Hoektronics/Mouth.IO/electronics/brainboard/brainboard.pdf

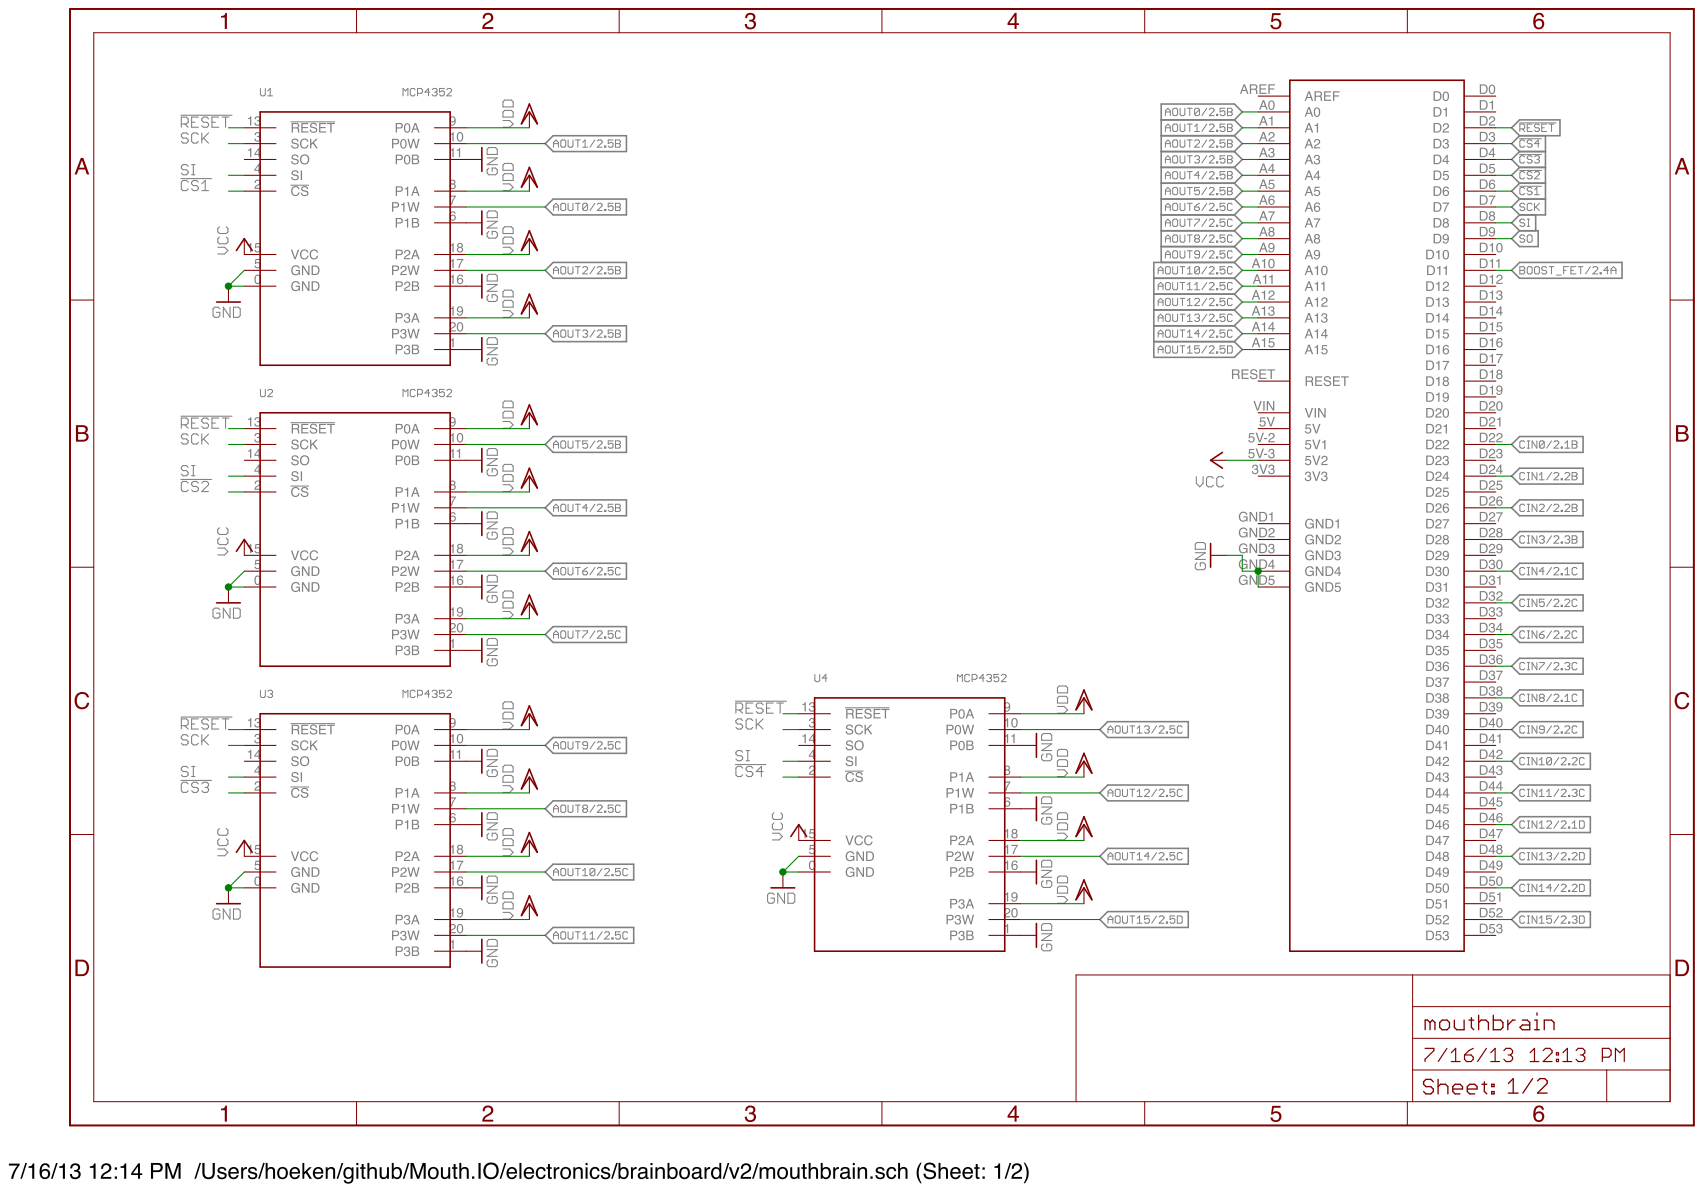
[picture p4: page 1]
