Hoektronics/Mouth.IO/electronics/tongueboard/tongueboard.pdf

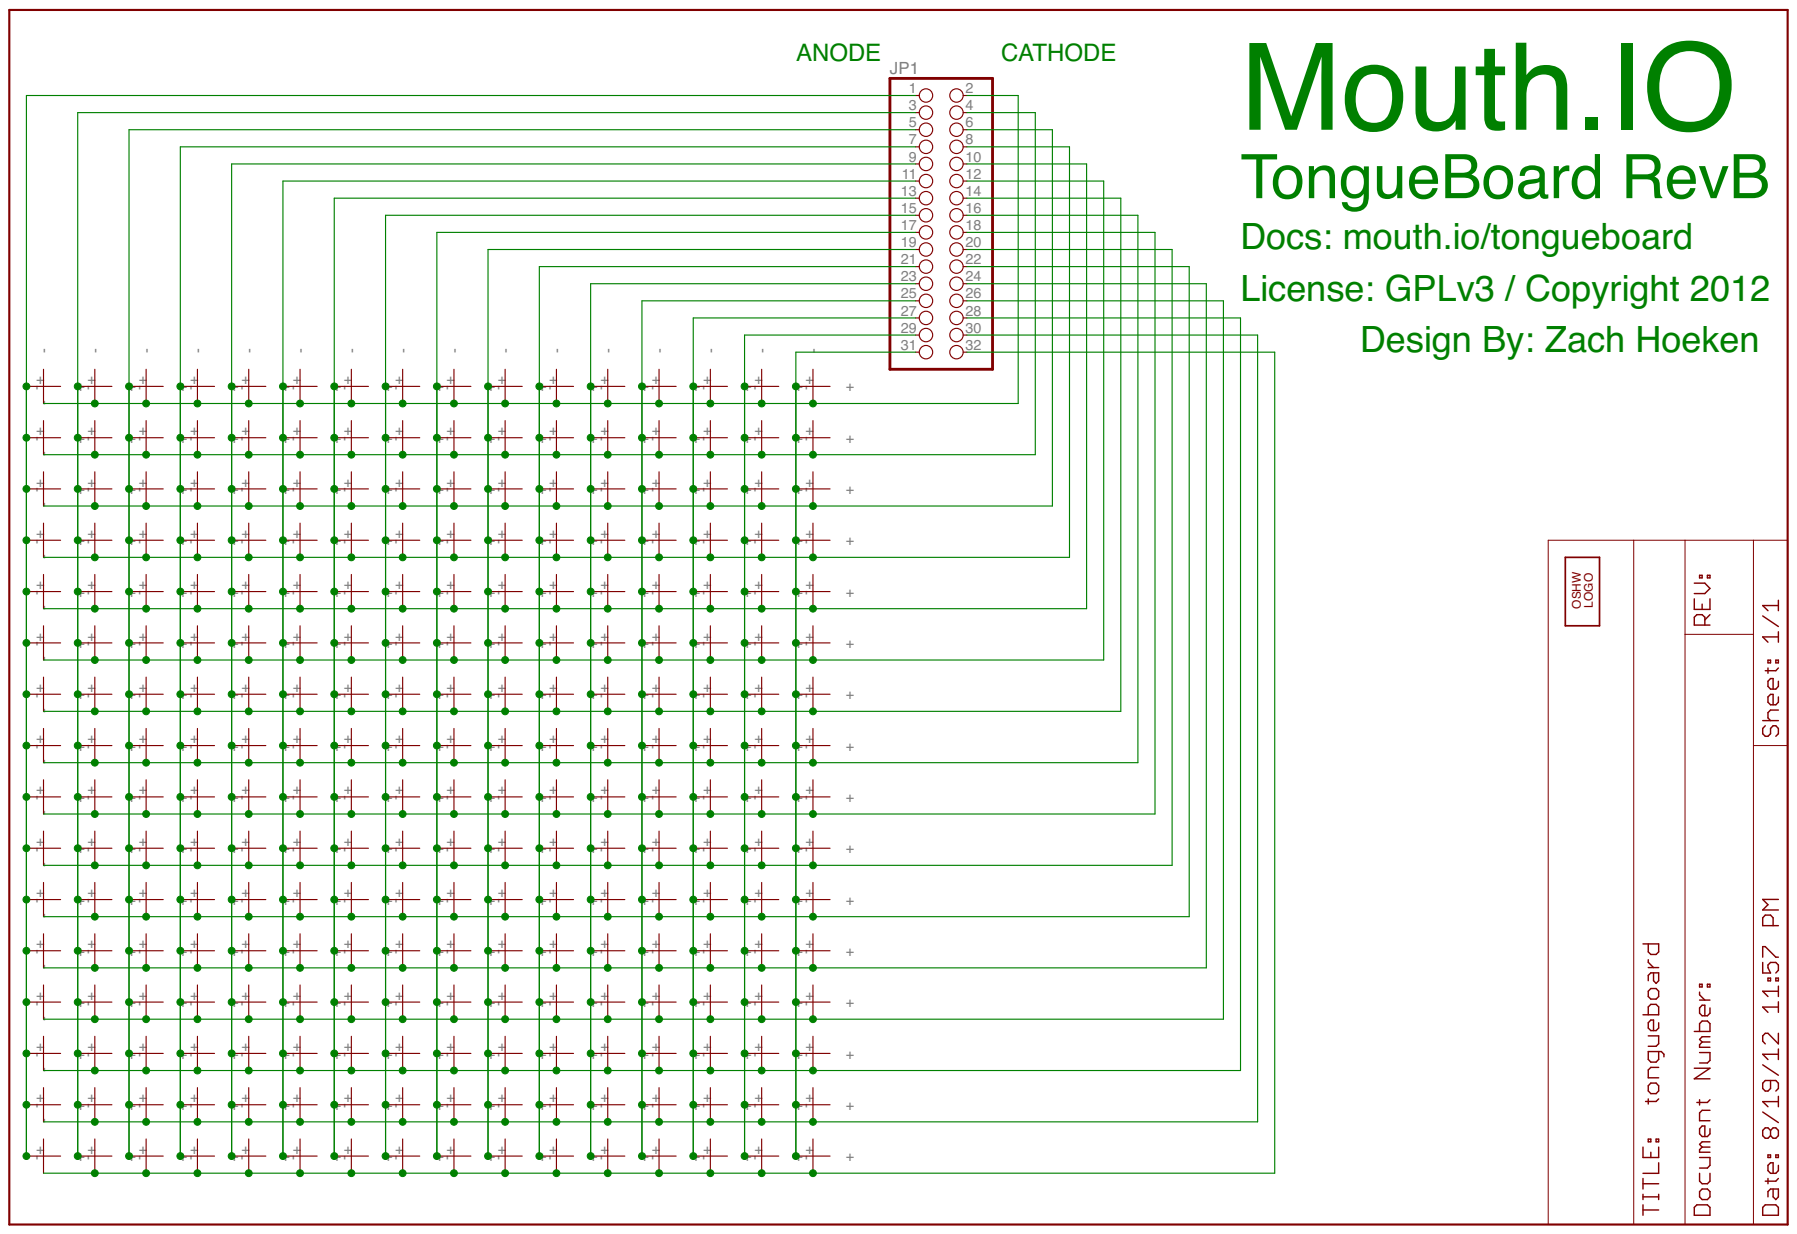
[picture p5: page 1]

Docs: mouth.io/tongueboard
License: GPLv3 / Copyright 2012

Design By: Zach Hoeken
