Hoektronics/Mouth.IO/electronics/brainboard/brainboard.brd

## EAGLE design electronics/brainboard/brainboard.brd (2013-07-16)

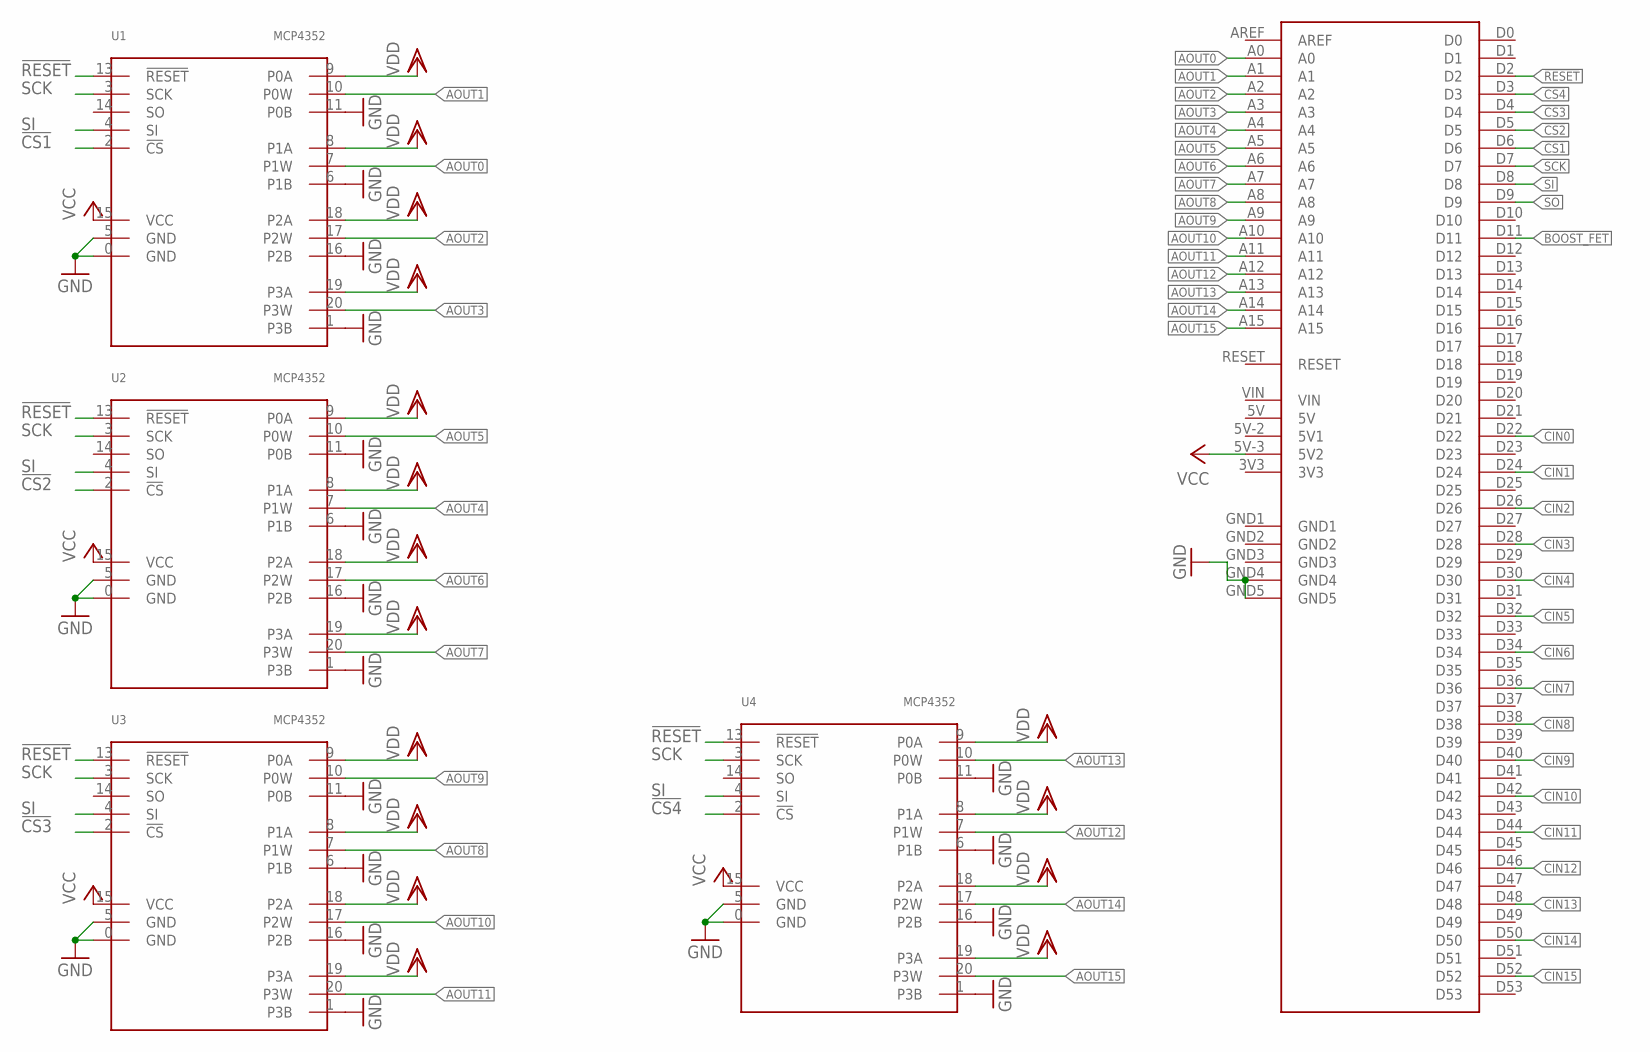
[picture p6: schematic brainboard.sch, sheet 1]

Parts:
U1, U2, U3, U4: MCP4352; QFN-20-PAD
U$3: ARDUINO-MEGA

Connections:
!CS1: U1.2 (!CS), U$3.D6
!CS2: U2.2 (!CS), U$3.D5
!CS3: U3.2 (!CS), U$3.D4
!CS4: U4.2 (!CS), U$3.D3
!RESET: U1.13 (!RESET), U2.13 (!RESET), U3.13 (!RESET), U4.13 (!RESET), U$3.D2
AOUT0: U1.7 (P1W), U$3.A0; also elsewhere on the board
AOUT1: U1.10 (P0W), U$3.A1; also elsewhere on the board
AOUT2: U1.17 (P2W), U$3.A2; also elsewhere on the board
AOUT3: U1.20 (P3W), U$3.A3; also elsewhere on the board
AOUT4: U2.7 (P1W), U$3.A4; also elsewhere on the board
AOUT5: U2.10 (P0W), U$3.A5; also elsewhere on the board
AOUT6: U2.17 (P2W), U$3.A6; also elsewhere on the board
AOUT7: U2.20 (P3W), U$3.A7; also elsewhere on the board
AOUT8: U3.7 (P1W), U$3.A8; also elsewhere on the board
AOUT9: U3.10 (P0W), U$3.A9; also elsewhere on the board
AOUT10: U3.17 (P2W), U$3.A10; also elsewhere on the board
AOUT11: U3.20 (P3W), U$3.A11; also elsewhere on the board
AOUT12: U4.7 (P1W), U$3.A12; also elsewhere on the board
AOUT13: U4.10 (P0W), U$3.A13; also elsewhere on the board
AOUT14: U4.17 (P2W), U$3.A14; also elsewhere on the board
AOUT15: U4.20 (P3W), U$3.A15; also elsewhere on the board
BOOST_FET: U$3.D11; also elsewhere on the board
CIN0: U$3.D22; also elsewhere on the board
CIN1: U$3.D24; also elsewhere on the board
CIN2: U$3.D26; also elsewhere on the board
CIN3: U$3.D28; also elsewhere on the board
CIN4: U$3.D30; also elsewhere on the board
CIN5: U$3.D32; also elsewhere on the board
CIN6: U$3.D34; also elsewhere on the board
CIN7: U$3.D36; also elsewhere on the board
CIN8: U$3.D38; also elsewhere on the board
CIN9: U$3.D40; also elsewhere on the board
CIN10: U$3.D42; also elsewhere on the board
CIN11: U$3.D44; also elsewhere on the board
CIN12: U$3.D46; also elsewhere on the board
CIN13: U$3.D48; also elsewhere on the board
CIN14: U$3.D50; also elsewhere on the board
CIN15: U$3.D52; also elsewhere on the board
GND: U1.0 (GND), U1.1 (P3B), U1.5 (GND), U1.6 (P1B), U1.11 (P0B), U1.16 (P2B), U2.0 (GND), U2.1 (P3B), U2.5 (GND), U2.6 (P1B), U2.11 (P0B), U2.16 (P2B), U3.0 (GND), U3.1 (P3B), U3.5 (GND), U3.6 (P1B), U3.11 (P0B), U3.16 (P2B), U4.0 (GND), U4.1 (P3B), U4.5 (GND), U4.6 (P1B), U4.11 (P0B), U4.16 (P2B), U$3.GND4, U$3.GND5; also elsewhere on the board
SCK: U1.3 (SCK), U2.3 (SCK), U3.3 (SCK), U4.3 (SCK), U$3.D7
SI: U1.4 (SI), U2.4 (SI), U3.4 (SI), U4.4 (SI), U$3.D8
SO: U$3.D9
VCC: U1.15 (VCC), U2.15 (VCC), U3.15 (VCC), U4.15 (VCC), U$3.5V-3 (5V2); also elsewhere on the board
VDD: U1.8 (P1A), U1.9 (P0A), U1.18 (P2A), U1.19 (P3A), U2.8 (P1A), U2.9 (P0A), U2.18 (P2A), U2.19 (P3A), U3.8 (P1A), U3.9 (P0A), U3.18 (P2A), U3.19 (P3A), U4.8 (P1A), U4.9 (P0A), U4.18 (P2A), U4.19 (P3A); also elsewhere on the board

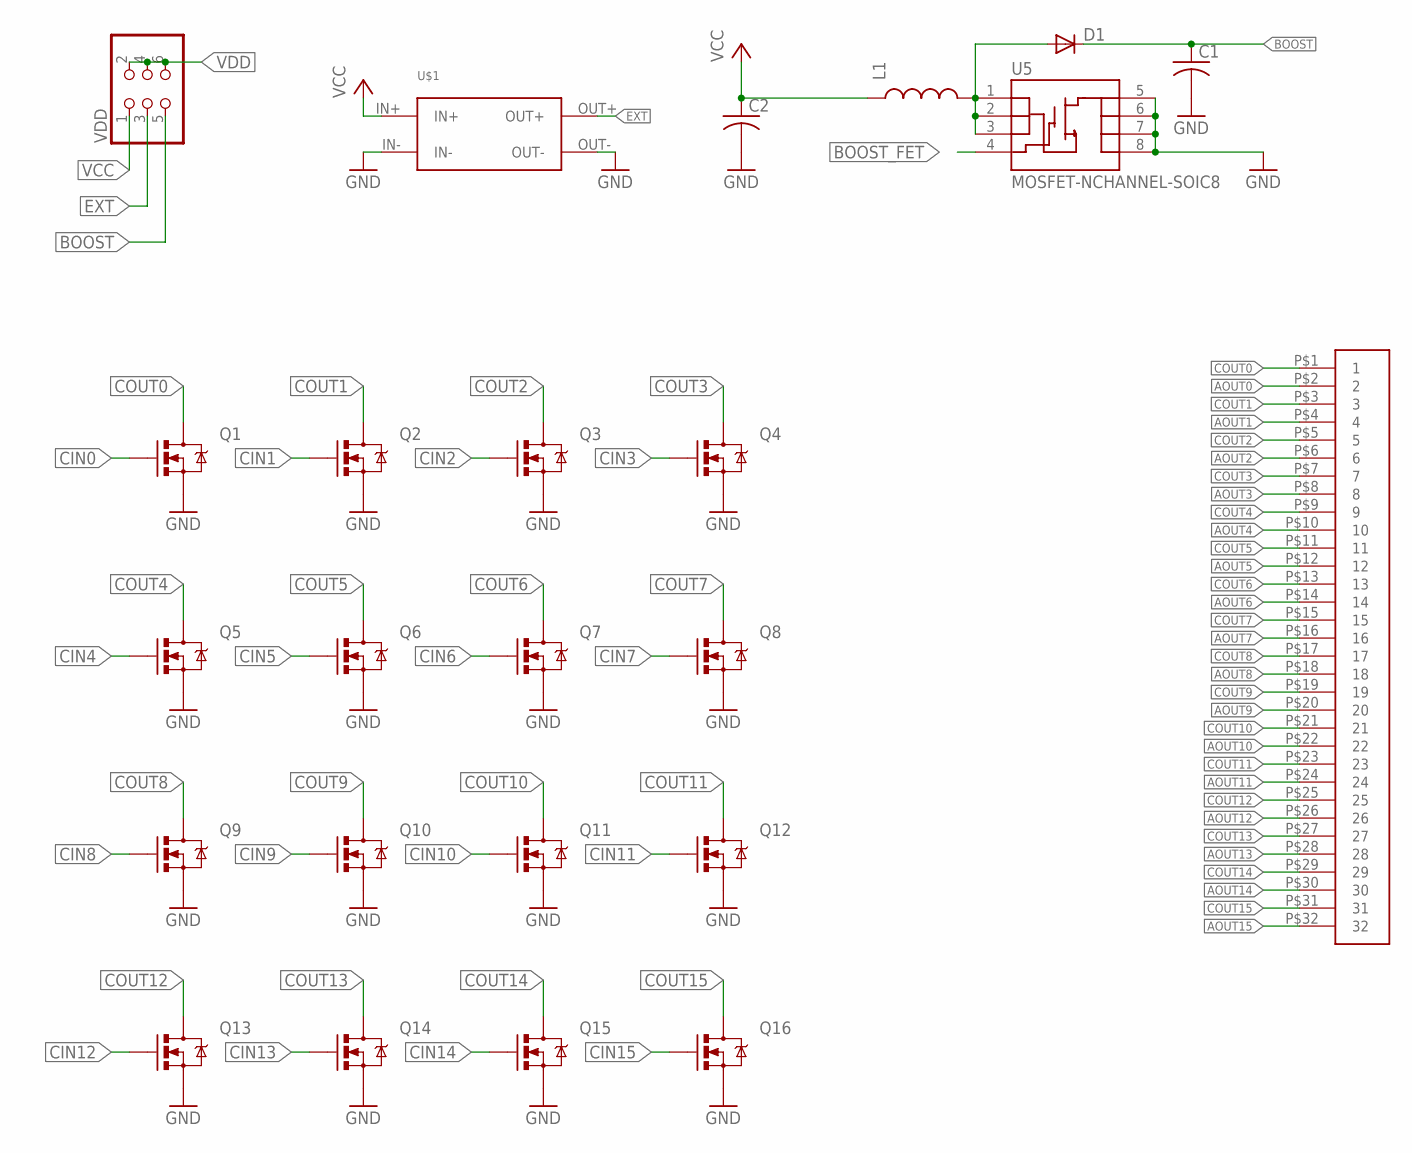
[picture p7: schematic brainboard.sch, sheet 2]

Parts:
C1, C2: C-USC1206; C1206
D1: DIODESMA; SMA-DIODE
L1: INDUCTOR1206H*; INDUCTOR-1206
Q1, Q2, Q3, Q4, Q5, Q6, Q7, Q8, Q9, Q10, Q11, Q12, Q13, Q14, Q15, Q16: MOSFET-NCHANNELSMD; SOT23-3
U5: MOSFET-NCHANNEL-SOIC8; SO08
U$1: DC-DC-CONVERTER; DC-DC-MODULE
U$2: FPC-0.5-32HORIZ; FPC-32-HORIZONTAL
VDD: PINHD-2X3; 2X03

Connections:
AOUT0: U$2.P$2 (2); also elsewhere on the board
AOUT1: U$2.P$4 (4); also elsewhere on the board
AOUT2: U$2.P$6 (6); also elsewhere on the board
AOUT3: U$2.P$8 (8); also elsewhere on the board
AOUT4: U$2.P$10 (10); also elsewhere on the board
AOUT5: U$2.P$12 (12); also elsewhere on the board
AOUT6: U$2.P$14 (14); also elsewhere on the board
AOUT7: U$2.P$16 (16); also elsewhere on the board
AOUT8: U$2.P$18 (18); also elsewhere on the board
AOUT9: U$2.P$20 (20); also elsewhere on the board
AOUT10: U$2.P$22 (22); also elsewhere on the board
AOUT11: U$2.P$24 (24); also elsewhere on the board
AOUT12: U$2.P$26 (26); also elsewhere on the board
AOUT13: U$2.P$28 (28); also elsewhere on the board
AOUT14: U$2.P$30 (30); also elsewhere on the board
AOUT15: U$2.P$32 (32); also elsewhere on the board
BOOST: C1.1, D1.C, VDD.5
BOOST_FET: U5.4 (G); also elsewhere on the board
CIN0: Q1.1 (G); also elsewhere on the board
CIN1: Q2.1 (G); also elsewhere on the board
CIN2: Q3.1 (G); also elsewhere on the board
CIN3: Q4.1 (G); also elsewhere on the board
CIN4: Q5.1 (G); also elsewhere on the board
CIN5: Q6.1 (G); also elsewhere on the board
CIN6: Q7.1 (G); also elsewhere on the board
CIN7: Q8.1 (G); also elsewhere on the board
CIN8: Q9.1 (G); also elsewhere on the board
CIN9: Q10.1 (G); also elsewhere on the board
CIN10: Q11.1 (G); also elsewhere on the board
CIN11: Q12.1 (G); also elsewhere on the board
CIN12: Q13.1 (G); also elsewhere on the board
CIN13: Q14.1 (G); also elsewhere on the board
CIN14: Q15.1 (G); also elsewhere on the board
CIN15: Q16.1 (G); also elsewhere on the board
COUT0: Q1.3 (D), U$2.P$1 (1)
COUT1: Q2.3 (D), U$2.P$3 (3)
COUT2: Q3.3 (D), U$2.P$5 (5)
COUT3: Q4.3 (D), U$2.P$7 (7)
COUT4: Q5.3 (D), U$2.P$9 (9)
COUT5: Q6.3 (D), U$2.P$11 (11)
COUT6: Q7.3 (D), U$2.P$13 (13)
COUT7: Q8.3 (D), U$2.P$15 (15)
COUT8: Q9.3 (D), U$2.P$17 (17)
COUT9: Q10.3 (D), U$2.P$19 (19)
COUT10: Q11.3 (D), U$2.P$21 (21)
COUT11: Q12.3 (D), U$2.P$23 (23)
COUT12: Q13.3 (D), U$2.P$25 (25)
COUT13: Q14.3 (D), U$2.P$27 (27)
COUT14: Q15.3 (D), U$2.P$29 (29)
COUT15: Q16.3 (D), U$2.P$31 (31)
EXT: U$1.OUT+, VDD.3
GND: C1.2, C2.2, Q1.2 (S), Q2.2 (S), Q3.2 (S), Q4.2 (S), Q5.2 (S), Q6.2 (S), Q7.2 (S), Q8.2 (S), Q9.2 (S), Q10.2 (S), Q11.2 (S), Q12.2 (S), Q13.2 (S), Q14.2 (S), Q15.2 (S), Q16.2 (S), U5.5 (D), U5.6 (D), U5.7 (D), U5.8 (D), U$1.IN-, U$1.OUT-; also elsewhere on the board
unnamed: D1.A, L1.P$2 (2), U5.1 (S), U5.2 (S), U5.3 (S)
VCC: C2.1, L1.P$1 (1), U$1.IN+, VDD.1; also elsewhere on the board
VDD: VDD.2, VDD.4, VDD.6; also elsewhere on the board

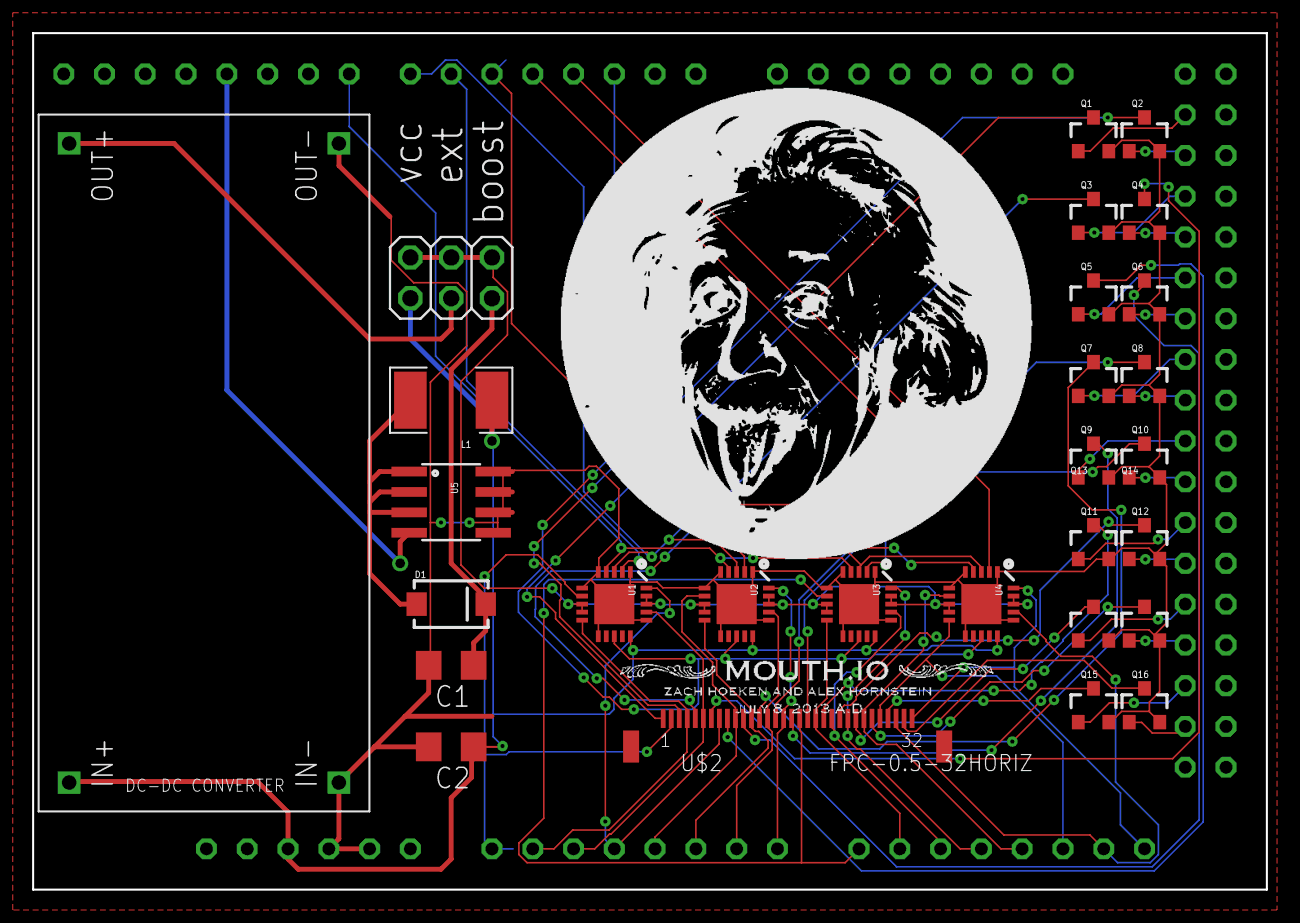
[picture p8: board brainboard.brd from above]

Board: 2 copper layers, 76.8 x 53.3 mm, 29 parts (0 on the bottom side), 62 nets.
