Hoektronics/Mouth.IO/electronics/tongueboard/tongueboard.brd

## EAGLE design electronics/tongueboard/tongueboard.brd (2013-07-11)

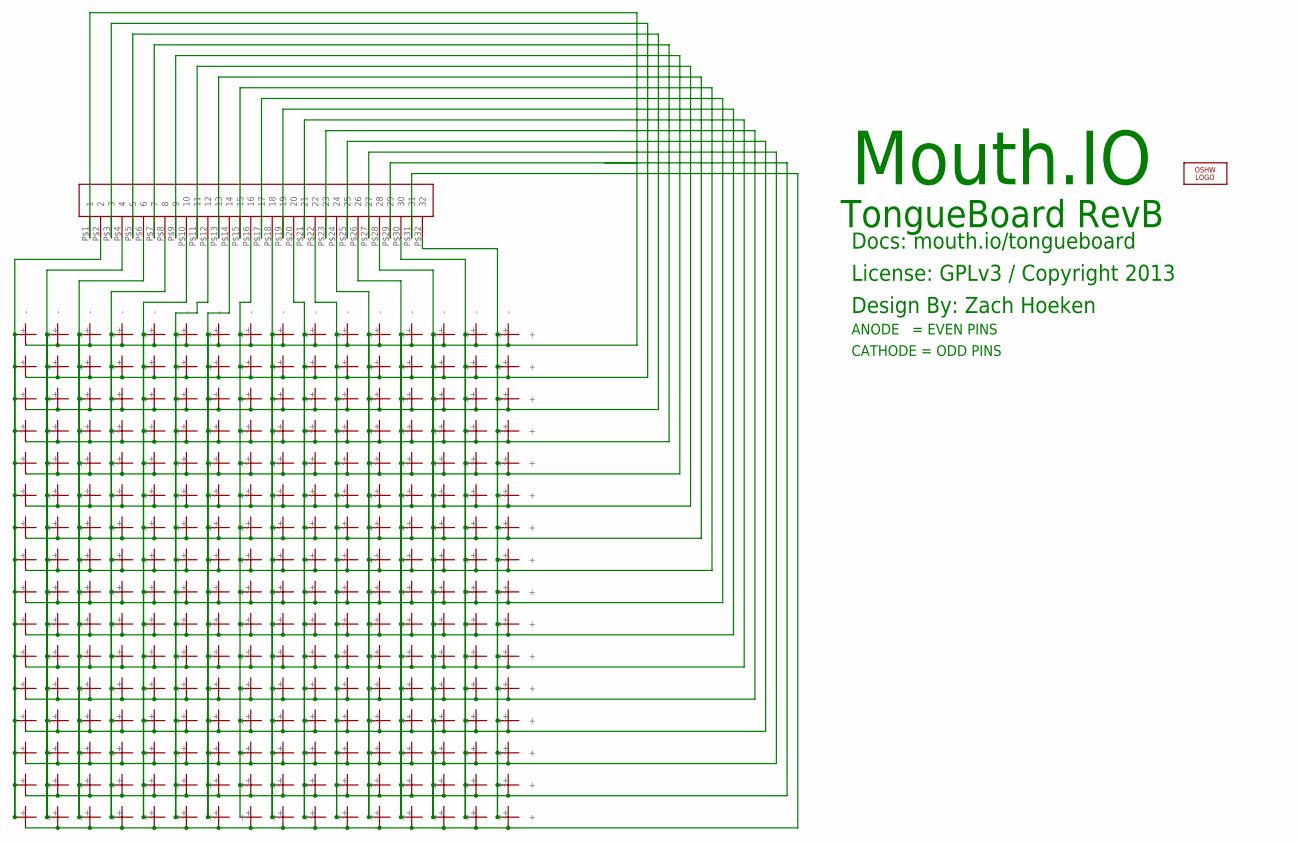
[picture p9: schematic tongueboard.sch]

Parts:
LOGO1: OSHW_LOGO_10MIL; OSHW_10X500_NOTEXT_COPPER
U$1, U$2, U$3, U$4, U$5, U$6, U$7, U$8, U$9, U$10, U$11, U$12, U$13, U$14, U$15, U$17, U$18, U$19, U$20, U$21, U$22, U$23, U$24, U$25, U$26, U$27, U$28, U$29, U$30, U$32, U$33, U$34, U$35, U$36, U$37, U$38, U$39, U$40, U$41, U$42, U$43, U$44, U$45, U$47, U$48, U$49, U$50, U$51, U$52, U$53, U$54, U$55, U$56, U$57, U$58, U$59, U$60, U$62, U$63, U$64, U$65, U$66, U$67, U$68, U$69, U$70, U$71, U$72, U$73, U$74, U$75, U$77, U$78, U$79, U$80, U$81, U$82, U$83, U$84, U$85, U$86, U$87, U$88, U$89, U$90, U$92, U$93, U$94, U$95, U$96, U$97, U$98, U$99, U$100, U$101, U$102, U$103, U$104, U$105, U$107, U$108, U$109, U$110, U$111, U$112, U$113, U$114, U$115, U$116, U$117, U$118, U$119, U$120, U$122, U$123, U$124, U$125, U$126, U$127, U$128, U$129, U$130, U$131, U$132, U$133, U$134, U$135, U$137, U$138, U$139, U$140, U$141, U$142, U$143, U$144, U$145, U$146, U$147, U$148, U$149, U$150, U$152, U$153, U$154, U$155, U$156, U$157, U$158, U$159, U$160, U$161, U$162, U$163, U$164, U$165, U$167, U$168, U$169, U$170, U$171, U$172, U$173, U$174, U$175, U$176, U$177, U$178, U$179, U$180, U$182, U$183, U$184, U$185, U$186, U$187, U$188, U$189, U$190, U$191, U$192, U$193, U$194, U$195, U$197, U$198, U$199, U$200, U$201, U$202, U$203, U$204, U$205, U$206, U$207, U$208, U$209, U$210, U$212, U$213, U$214, U$215, U$216, U$217, U$218, U$219, U$220, U$221, U$222, U$223, U$224, U$225, U$227, U$228, U$229, U$230, U$231, U$232, U$233, U$234, U$235, U$236, U$237, U$238, U$239, U$240, U$242, U$243, U$244, U$245, U$246, U$247, U$248, U$249, U$250, U$251, U$252, U$253, U$254, U$255, U$256: ELECTRODE60MIL; 61MIL
U$16, U$31, U$46, U$61, U$76, U$91, U$106, U$121, U$136, U$151, U$166, U$181, U$196, U$211, U$226, U$241: ELECTRODE61MILJCT; 61MILJCT
U$257: FPC-0.5-32; FPC-32-WIRE

Connections:
A0: U$1.+, U$17.+, U$33.+, U$49.+, U$65.+, U$81.+, U$97.+, U$113.+, U$129.+, U$145.+, U$161.+, U$177.+, U$193.+, U$209.+, U$225.+, U$241.+, U$257.P$2 (2)
A1: U$2.+, U$18.+, U$34.+, U$50.+, U$66.+, U$82.+, U$98.+, U$114.+, U$130.+, U$146.+, U$162.+, U$178.+, U$194.+, U$210.+, U$226.+, U$242.+, U$257.P$4 (4)
A2: U$3.+, U$19.+, U$35.+, U$51.+, U$67.+, U$83.+, U$99.+, U$115.+, U$131.+, U$147.+, U$163.+, U$179.+, U$195.+, U$211.+, U$227.+, U$243.+, U$257.P$6 (6)
A3: U$4.+, U$20.+, U$36.+, U$52.+, U$68.+, U$84.+, U$100.+, U$116.+, U$132.+, U$148.+, U$164.+, U$180.+, U$196.+, U$212.+, U$228.+, U$244.+, U$257.P$8 (8)
A4: U$5.+, U$21.+, U$37.+, U$53.+, U$69.+, U$85.+, U$101.+, U$117.+, U$133.+, U$149.+, U$165.+, U$181.+, U$197.+, U$213.+, U$229.+, U$245.+, U$257.P$10 (10)
A5: U$6.+, U$22.+, U$38.+, U$54.+, U$70.+, U$86.+, U$102.+, U$118.+, U$134.+, U$150.+, U$166.+, U$182.+, U$198.+, U$214.+, U$230.+, U$246.+, U$257.P$12 (12)
A6: U$7.+, U$23.+, U$39.+, U$55.+, U$71.+, U$87.+, U$103.+, U$119.+, U$135.+, U$151.+, U$167.+, U$183.+, U$199.+, U$215.+, U$231.+, U$247.+, U$257.P$14 (14)
A7: U$8.+, U$24.+, U$40.+, U$56.+, U$72.+, U$88.+, U$104.+, U$120.+, U$136.+, U$152.+, U$168.+, U$184.+, U$200.+, U$216.+, U$232.+, U$248.+, U$257.P$16 (16)
A8: U$9.+, U$25.+, U$41.+, U$57.+, U$73.+, U$89.+, U$105.+, U$121.+, U$137.+, U$153.+, U$169.+, U$185.+, U$201.+, U$217.+, U$233.+, U$249.+, U$257.P$18 (18)
A9: U$10.+, U$26.+, U$42.+, U$58.+, U$74.+, U$90.+, U$106.+, U$122.+, U$138.+, U$154.+, U$170.+, U$186.+, U$202.+, U$218.+, U$234.+, U$250.+, U$257.P$20 (20)
A10: U$11.+, U$27.+, U$43.+, U$59.+, U$75.+, U$91.+, U$107.+, U$123.+, U$139.+, U$155.+, U$171.+, U$187.+, U$203.+, U$219.+, U$235.+, U$251.+, U$257.P$22 (22)
A11: U$12.+, U$28.+, U$44.+, U$60.+, U$76.+, U$92.+, U$108.+, U$124.+, U$140.+, U$156.+, U$172.+, U$188.+, U$204.+, U$220.+, U$236.+, U$252.+, U$257.P$24 (24)
A12: U$13.+, U$29.+, U$45.+, U$61.+, U$77.+, U$93.+, U$109.+, U$125.+, U$141.+, U$157.+, U$173.+, U$189.+, U$205.+, U$221.+, U$237.+, U$253.+, U$257.P$26 (26)
A13: U$14.+, U$30.+, U$46.+, U$62.+, U$78.+, U$94.+, U$110.+, U$126.+, U$142.+, U$158.+, U$174.+, U$190.+, U$206.+, U$222.+, U$238.+, U$254.+, U$257.P$28 (28)
A14: U$15.+, U$31.+, U$47.+, U$63.+, U$79.+, U$95.+, U$111.+, U$127.+, U$143.+, U$159.+, U$175.+, U$191.+, U$207.+, U$223.+, U$239.+, U$255.+, U$257.P$30 (30)
A15: U$16.+, U$32.+, U$48.+, U$64.+, U$80.+, U$96.+, U$112.+, U$128.+, U$144.+, U$160.+, U$176.+, U$192.+, U$208.+, U$224.+, U$240.+, U$256.+, U$257.P$32 (32)
C0: U$241.-, U$242.-, U$243.-, U$244.-, U$245.-, U$246.-, U$247.-, U$248.-, U$249.-, U$250.-, U$251.-, U$252.-, U$253.-, U$254.-, U$255.-, U$256.-, U$257.P$1 (1)
C1: U$225.-, U$226.-, U$227.-, U$228.-, U$229.-, U$230.-, U$231.-, U$232.-, U$233.-, U$234.-, U$235.-, U$236.-, U$237.-, U$238.-, U$239.-, U$240.-, U$257.P$3 (3)
C2: U$209.-, U$210.-, U$211.-, U$212.-, U$213.-, U$214.-, U$215.-, U$216.-, U$217.-, U$218.-, U$219.-, U$220.-, U$221.-, U$222.-, U$223.-, U$224.-, U$257.P$5 (5)
C3: U$193.-, U$194.-, U$195.-, U$196.-, U$197.-, U$198.-, U$199.-, U$200.-, U$201.-, U$202.-, U$203.-, U$204.-, U$205.-, U$206.-, U$207.-, U$208.-, U$257.P$7 (7)
C4: U$177.-, U$178.-, U$179.-, U$180.-, U$181.-, U$182.-, U$183.-, U$184.-, U$185.-, U$186.-, U$187.-, U$188.-, U$189.-, U$190.-, U$191.-, U$192.-, U$257.P$9 (9)
C5: U$161.-, U$162.-, U$163.-, U$164.-, U$165.-, U$166.-, U$167.-, U$168.-, U$169.-, U$170.-, U$171.-, U$172.-, U$173.-, U$174.-, U$175.-, U$176.-, U$257.P$11 (11)
C6: U$145.-, U$146.-, U$147.-, U$148.-, U$149.-, U$150.-, U$151.-, U$152.-, U$153.-, U$154.-, U$155.-, U$156.-, U$157.-, U$158.-, U$159.-, U$160.-, U$257.P$13 (13)
C7: U$129.-, U$130.-, U$131.-, U$132.-, U$133.-, U$134.-, U$135.-, U$136.-, U$137.-, U$138.-, U$139.-, U$140.-, U$141.-, U$142.-, U$143.-, U$144.-, U$257.P$15 (15)
C8: U$113.-, U$114.-, U$115.-, U$116.-, U$117.-, U$118.-, U$119.-, U$120.-, U$121.-, U$122.-, U$123.-, U$124.-, U$125.-, U$126.-, U$127.-, U$128.-, U$257.P$17 (17)
C9: U$97.-, U$98.-, U$99.-, U$100.-, U$101.-, U$102.-, U$103.-, U$104.-, U$105.-, U$106.-, U$107.-, U$108.-, U$109.-, U$110.-, U$111.-, U$112.-, U$257.P$19 (19)
C10: U$81.-, U$82.-, U$83.-, U$84.-, U$85.-, U$86.-, U$87.-, U$88.-, U$89.-, U$90.-, U$91.-, U$92.-, U$93.-, U$94.-, U$95.-, U$96.-, U$257.P$21 (21)
C11: U$65.-, U$66.-, U$67.-, U$68.-, U$69.-, U$70.-, U$71.-, U$72.-, U$73.-, U$74.-, U$75.-, U$76.-, U$77.-, U$78.-, U$79.-, U$80.-, U$257.P$23 (23)
C12: U$49.-, U$50.-, U$51.-, U$52.-, U$53.-, U$54.-, U$55.-, U$56.-, U$57.-, U$58.-, U$59.-, U$60.-, U$61.-, U$62.-, U$63.-, U$64.-, U$257.P$25 (25)
C13: U$33.-, U$34.-, U$35.-, U$36.-, U$37.-, U$38.-, U$39.-, U$40.-, U$41.-, U$42.-, U$43.-, U$44.-, U$45.-, U$46.-, U$47.-, U$48.-, U$257.P$27 (27)
C14: U$17.-, U$18.-, U$19.-, U$20.-, U$21.-, U$22.-, U$23.-, U$24.-, U$25.-, U$26.-, U$27.-, U$28.-, U$29.-, U$30.-, U$31.-, U$32.-, U$257.P$29 (29)
C15: U$1.-, U$2.-, U$3.-, U$4.-, U$5.-, U$6.-, U$7.-, U$8.-, U$9.-, U$10.-, U$11.-, U$12.-, U$13.-, U$14.-, U$15.-, U$16.-, U$257.P$31 (31)

Notes on the sheet:
Mouth.IO
TongueBoard RevB
ANODE = EVEN PINS
CATHODE = ODD PINS
Docs: mouth.io/tongueboard
License: GPLv3 / Copyright 2013
Design By: Zach Hoeken

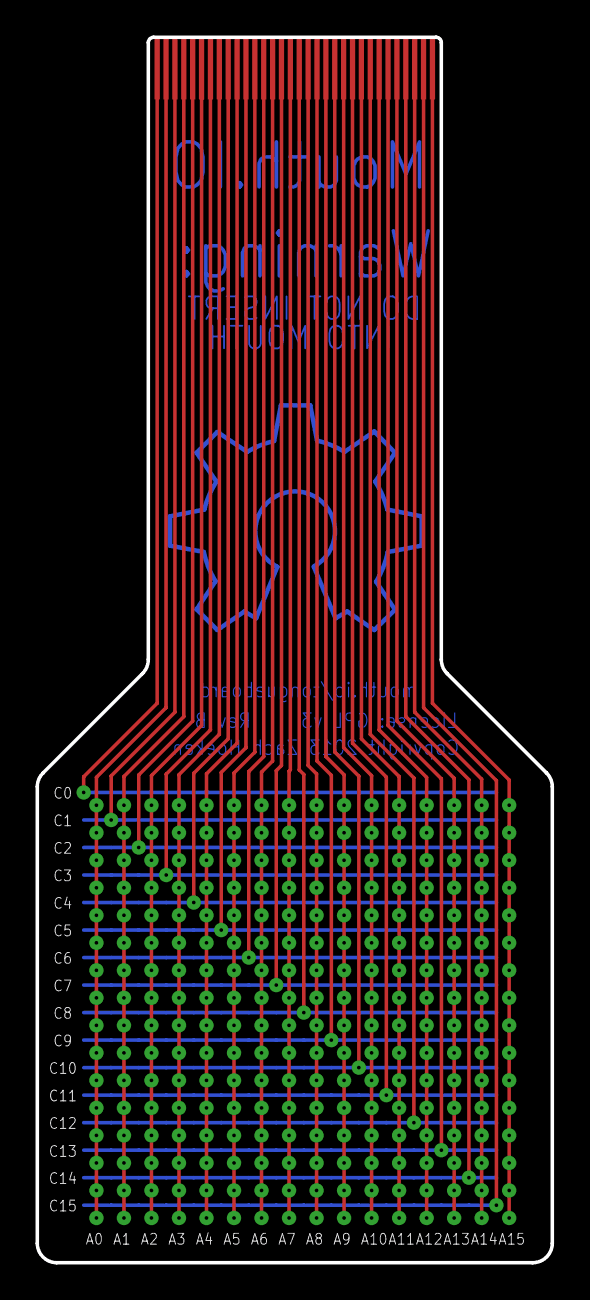
[picture p10: board tongueboard.brd from above]

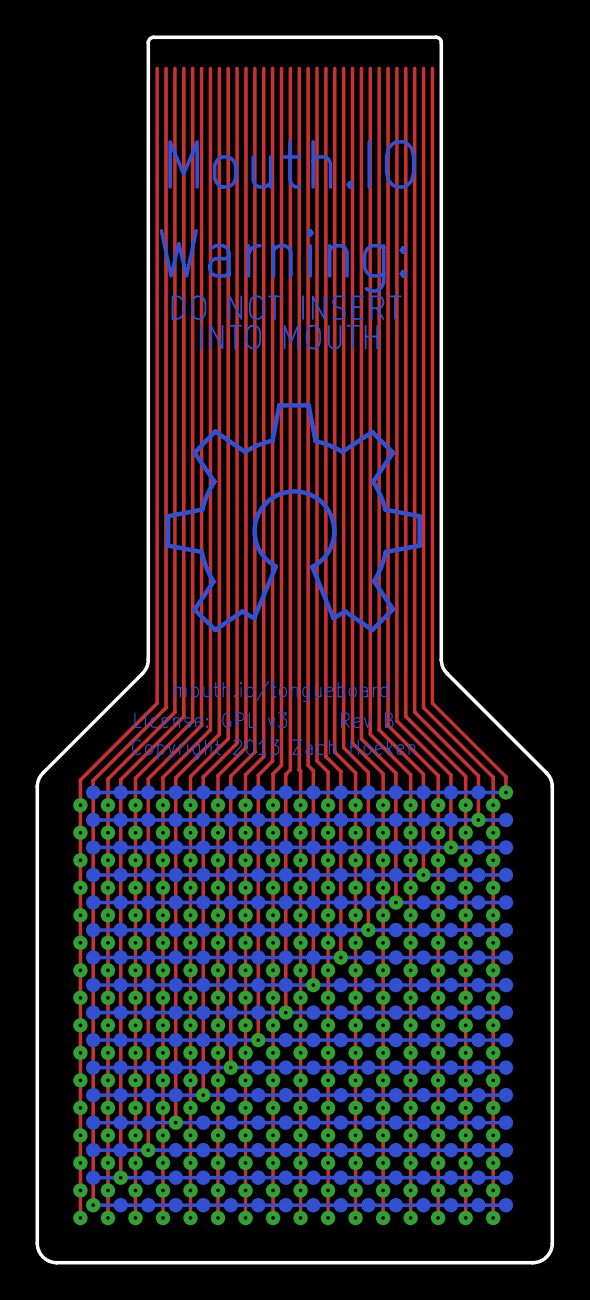
[picture p11: board tongueboard.brd from below]

Board: 2 copper layers, 29.0 x 69.0 mm, 258 parts (256 on the bottom side), 32 nets.
