Hoektronics/Mouth.IO/(commit log)

2012-05-10 overhauled the mouthbrain + brainboard designs. still need to route the brainboard.
    [brainboard.brd, brainboard.sch, mouthbrain.brd, mouthbrain.sch]
2012-05-11 started laying out the brainboard with the new circuit.
    [brainboard.brd]
2012-05-11 finished the first pass layout of the new board.
    [brainboard.brd, brainboard.sch]
2012-06-18 tidied up the brainboard for revB release
    [brainboard.brd, brainboard.sch]
2012-06-18 removed old irrelevant files.
    [mouth-mouse.brd, mouth-mouse.sch]
2012-06-18 renamed mouthbrain to tongboard.
    [tongueboard.brd, tongueboard.sch]
2012-06-21 finished the silkscreen on the tongueboard
    [tongueboard.brd, tongueboard.sch]
2012-08-19 added urls and frames and such and got ready for a release.
    [brainboard.brd, brainboard.sch, tongueboard.brd, tongueboard.sch]
2012-08-19 added release drill and pdf files.
    [brainboard.drl, tongueboard.drl]
2012-08-19 fixed polygons on brainboard.
    [brainboard.brd]
2012-08-19 fixed silkscreen errors to prep for prototypes.
    [brainboard.brd]
2013-07-07 picked back up the project, converted tongueboard to fpc.
    [tongueboard.brd, tongueboard.sch]
2013-07-07 added brainboard v2, brainboard with digipots and variable voltage boost converter
    [mouthbrain.brd, mouthbrain.sch]
2013-07-08 tongueboard ready for release.
    [tongueboard.brd, tongueboard.sch]
2013-07-08 circuit is ready to rock and roll.
    [mouthbrain.brd, mouthbrain.sch]
2013-07-08 routed the brainboard
    [mouthbrain.brd, mouthbrain.sch]
2013-07-09 latest routing
    [mouthbrain.brd]
2013-07-09 routed a bunch of the brainboard.
    [mouthbrain.brd, mouthbrain.sch, tongueboard.brd, tongueboard.sch]
2013-07-09 layout mods to the brainboard.
    [mouthbrain.brd]
2013-07-09 switched ADCs to package with ground pad
    [mouthbrain.brd.BACKUP.36720.brd, mouthbrain.brd.BACKUP.36807.brd, mouthbrain.brd.BASE.36720.brd, mouthbrain.brd.BASE.36807.brd, mouthbrain.brd.LOCAL.36720.brd, mouthbrain.brd.LOCAL.36807.brd, mouthbrain.brd.REMOTE.36720.brd, mouthbrain.brd.REMOTE.36807.brd]
2013-07-11 tweaked the settings for soldermask.
    [tongueboard.brd]
2013-07-16 mouthbrain ready for prototyping.
    [mouthbrain.brd, mouthbrain.sch]
2013-07-16 added important release docs.
    [mouthbrain.drl]
2013-07-16 restructuring #1.
    [brainboard.brd, brainboard.sch, mouthbrain.brd, mouthbrain.brd.BACKUP.36720.brd, mouthbrain.brd.BACKUP.36807.brd, mouthbrain.brd.BASE.36720.brd, mouthbrain.brd.BASE.36807.brd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]
2013-07-16 restructure #2
    [mouthbrain.brd, mouthbrain.brd.BACKUP.36720.brd, mouthbrain.brd.BACKUP.36807.brd, mouthbrain.brd.BASE.36720.brd, mouthbrain.brd.BASE.36807.brd, mouthbrain.brd.LOCAL.36720.brd, mouthbrain.brd.LOCAL.36807.brd, mouthbrain.brd.REMOTE.36720.brd]
2013-07-16 fully restructured.
    [brainboard.brd, brainboard.sch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]
2013-07-22 created an arduino library for Mouthio
