Hoektronics/Mouth.IO/(notices)

Notices in the files:
electronics/tongueboard/tongueboard.brd:
Copyright 2013 Zach Hoeken
License: GPL v3 Rev B
parts and their libraries:
SparkFun: Licensing: CC v3.0 Share-Alike You are welcome to use this library for commercial purposes.
